dgullage702/Autonomous-Thermal-Guided-Flame-Suppression-Turret/firmware/README.md

# Firmware
Arduino sketches for the ESP32.

- `pan_servo_test` - moves the pan servo center, left, center, right
- `pan_tilt_test` - moves both servos together
- `thermal_test` - reads the thermal camera and prints min/max temperature
- `hotspot_test` - finds the hottest pixel and prints its x/y position
