dgullage702/Autonomous-Thermal-Guided-Flame-Suppression-Turret/cad/draft_1/all_parts.3mf

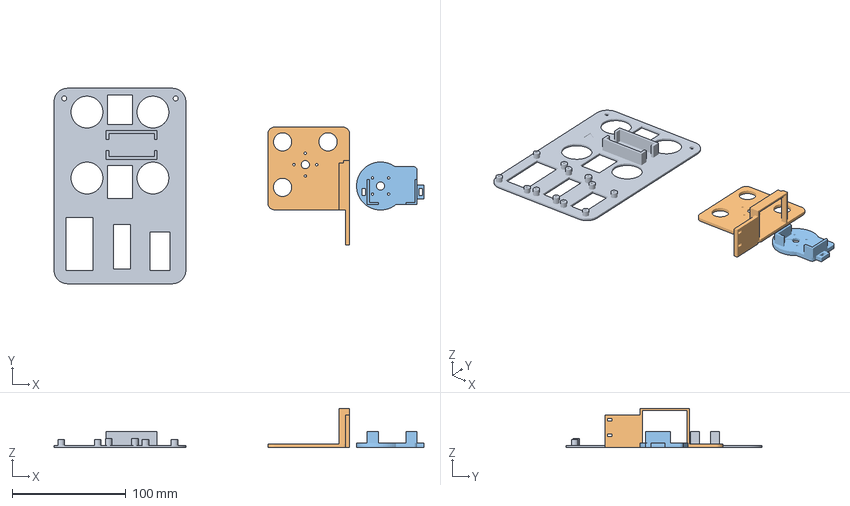
[picture p7: CAD file, 2026-10-28]
cad/draft_1/all_parts.3mf
325.4 x 172.0 x 34.4 mm
base
tilt head
pan bracket
