dgullage702/Autonomous-Thermal-Guided-Flame-Suppression-Turret/cad/draft_2/turret_base.3mf

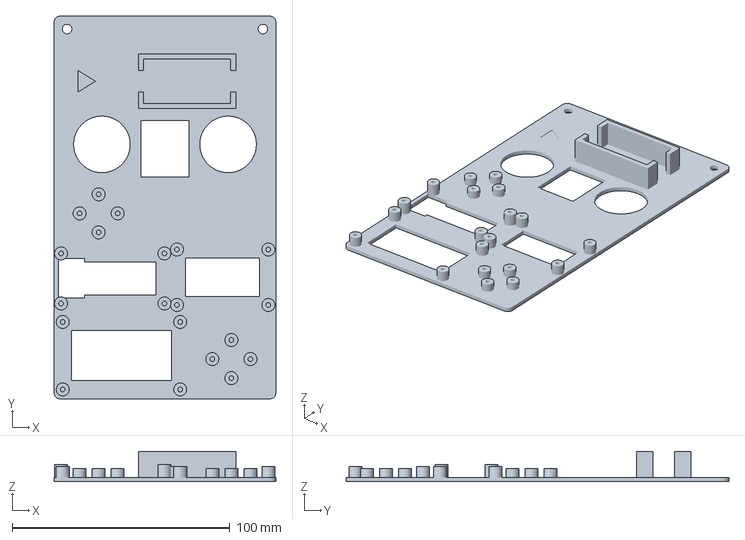
[picture p8: CAD file, 2026-10-30]
cad/draft_2/turret_base.3mf
102.0 x 176.0 x 14.0 mm
