dgullage702/Autonomous-Thermal-Guided-Flame-Suppression-Turret/cad/draft_1/turret_base.3mf

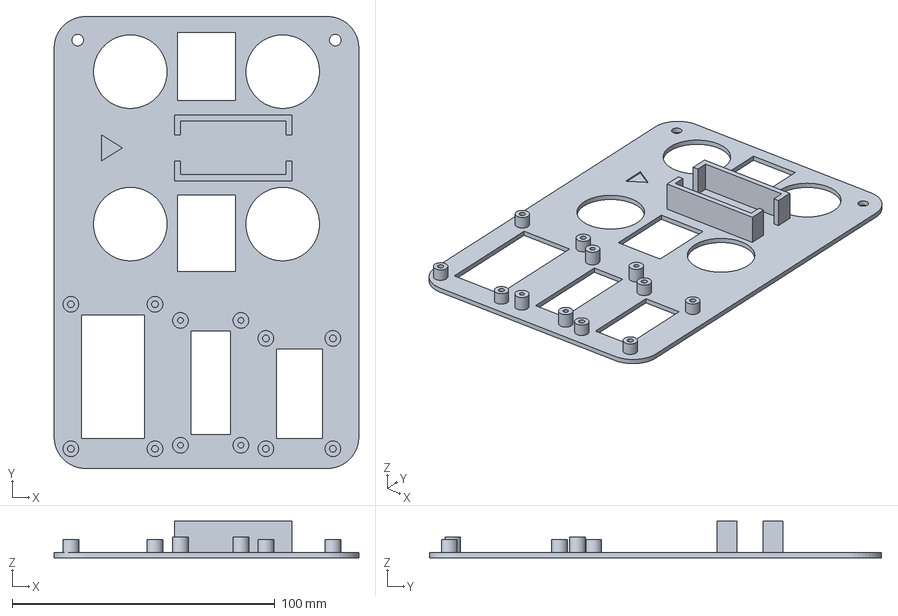
[picture p9: CAD file, 2026-10-28]
cad/draft_1/turret_base.3mf
116.0 x 172.0 x 14.0 mm
