dgullage702/Autonomous-Thermal-Guided-Flame-Suppression-Turret/cad/draft_2/all_parts.3mf

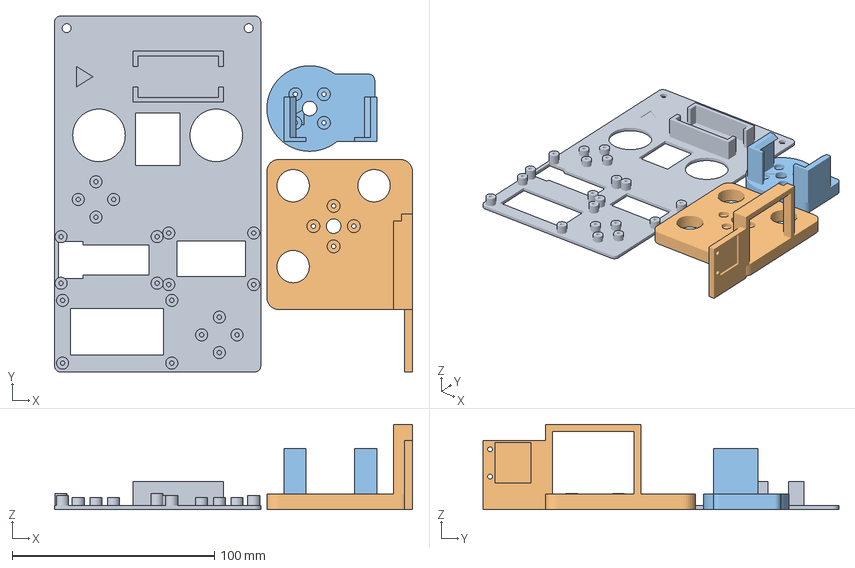
[picture p10: CAD file, 2026-10-30]
cad/draft_2/all_parts.3mf
177.0 x 176.0 x 42.1 mm
base
tilt head
pan bracket
