dgullage702/Autonomous-Thermal-Guided-Flame-Suppression-Turret/cad/draft_1/pan_bracket.3mf

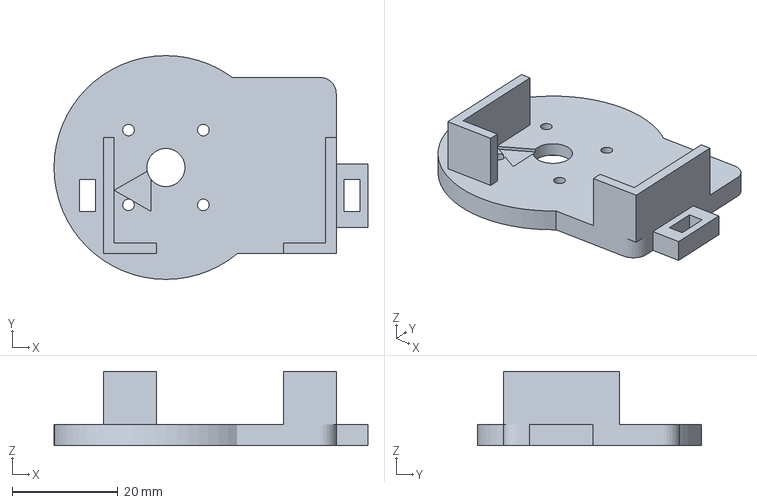
[picture p11: CAD file, 2026-10-28]
cad/draft_1/pan_bracket.3mf
59.3 x 42.3 x 14.0 mm
