dgullage702/Autonomous-Thermal-Guided-Flame-Suppression-Turret/cad/draft_2/tilt_head.3mf

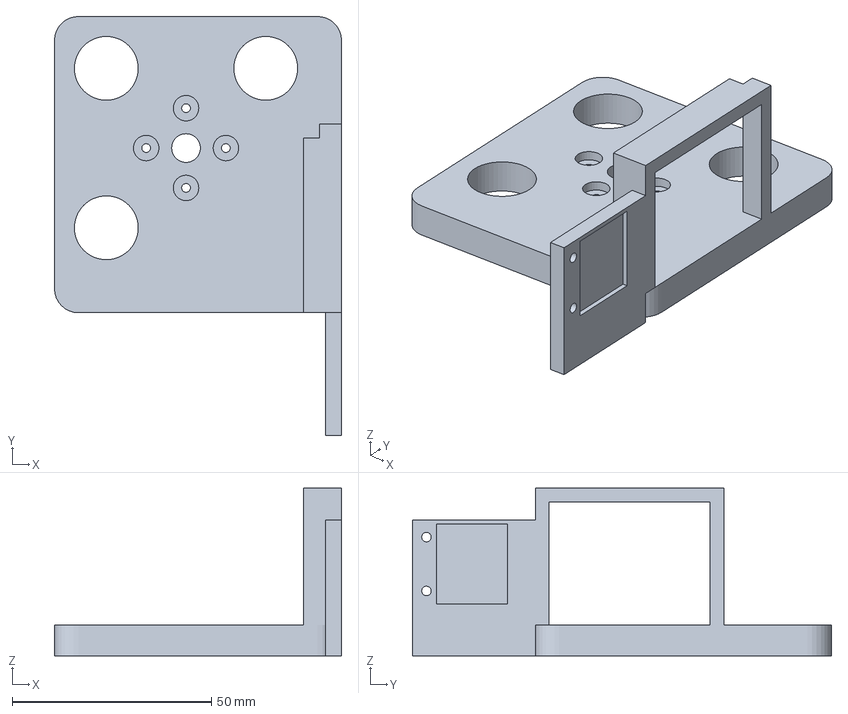
[picture p12: CAD file, 2026-10-30]
cad/draft_2/tilt_head.3mf
72.0 x 105.1 x 42.1 mm
