dgullage702/Autonomous-Thermal-Guided-Flame-Suppression-Turret/cad/draft_1/tilt_head.3mf

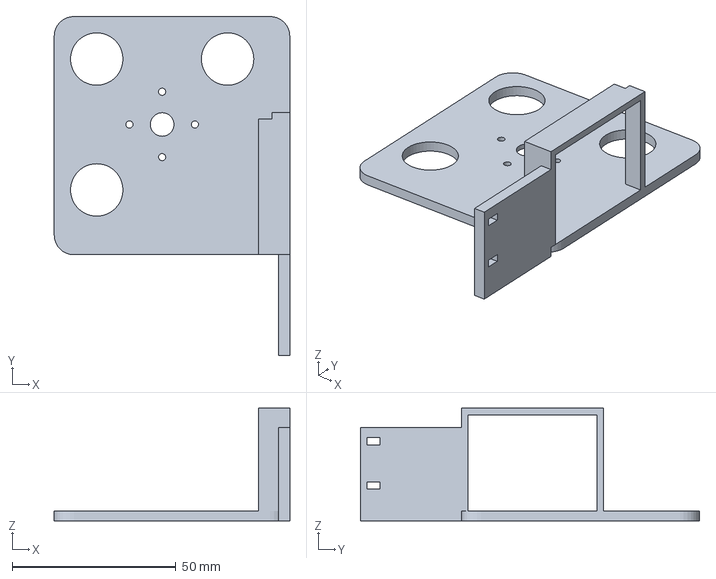
[picture p13: CAD file, 2026-10-28]
cad/draft_1/tilt_head.3mf
72.0 x 103.6 x 34.4 mm
