dgullage702/Autonomous-Thermal-Guided-Flame-Suppression-Turret/cad/draft_2/pan_bracket.3mf

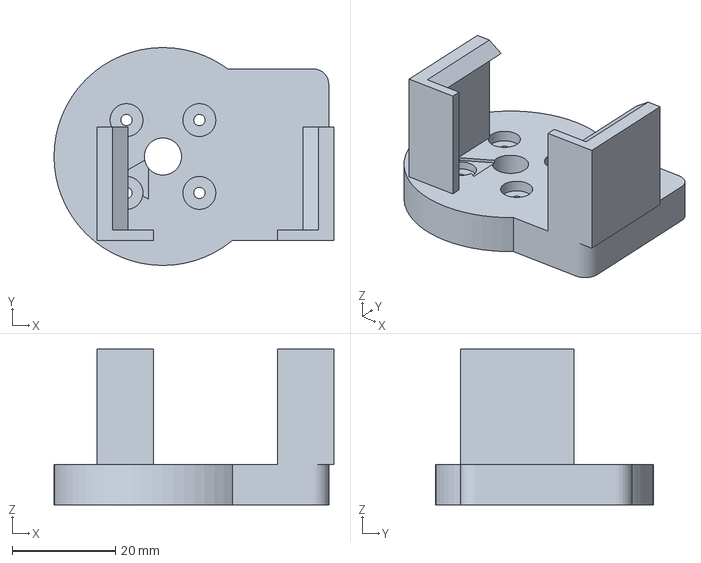
[picture p14: CAD file, 2026-10-30]
cad/draft_2/pan_bracket.3mf
54.3 x 42.3 x 30.2 mm
