dgullage702/Autonomous-Thermal-Guided-Flame-Suppression-Turret/(commit log)

2026-10-28 Set up buck converter for servo power
2026-10-28 Pan servo wired and moving
2026-10-28 Update pan servo notes
2026-10-28 Add pan servo photo
2026-10-28 Add tilt servo, breadboard power, and servo test sketches
2026-10-28 Thermal camera reading temperatures
2026-10-28 Add turret base for pan servo
    [turret_base.3mf]
2026-10-28 Add pan bracket and tilt head
    [pan_bracket.3mf, tilt_head.3mf]
2026-10-28 Add all-parts print plate
    [turret_base.3mf, turret_v1_all_parts.3mf]
2026-10-28 Lighter base and bracket
    [pan_bracket.3mf, turret_base.3mf, turret_v1_all_parts.3mf]
2026-10-28 Update V1 description, parts list, and printed parts
2026-10-28 Tighten servo pockets and widen fan sleeve after fit test
    [pan_bracket.3mf, tilt_head.3mf, turret_base.3mf, turret_v1_all_parts.3mf]
2026-10-28 Add electronics mounts to base, split parts onto two plates
    [pan_bracket.3mf, tilt_head.3mf, turret_base.3mf, turret_v1_all_parts.3mf]
2026-10-28 Lighter base plate
    [turret_base.3mf, turret_v1_all_parts.3mf]
2026-10-29 Fix cross horn recess on pan bracket and tilt head
    [pan_bracket.3mf, tilt_head.3mf, turret_v1_all_parts.3mf]
2026-10-29 Keep first print files, move fixes to print_v2
    [all_parts.3mf, pan_bracket.3mf, tilt_head.3mf, turret_base.3mf]
2026-10-29 Rename print folders to drafts
    [all_parts.3mf, pan_bracket.3mf, tilt_head.3mf, turret_base.3mf]
2026-10-29 Draft 2: bigger, thicker fan sleeve
    [all_parts.3mf, tilt_head.3mf]
2026-10-30 Draft 2: tilt servo strap, camera tab holes, M2 board posts
    [all_parts.3mf, pan_bracket.3mf, servo_strap.3mf, tilt_head.3mf, turret_base.3mf]
2026-10-30 Draft 2: slide-in tilt servo pocket, flush screw heads, roomier fan sleeve
    [all_parts.3mf, pan_bracket.3mf, servo_strap.3mf, tilt_head.3mf, turret_base.3mf]
2026-10-30 Draft 2: deeper, looser horn pockets and screws kept clear of the servos
    [all_parts.3mf, pan_bracket.3mf, tilt_head.3mf]
2026-10-30 Draft 2: one-plate layout with lever splitter mounts, standard print settings
    [all_parts.3mf, pan_bracket.3mf, tilt_head.3mf, turret_base.3mf]
